horga83/Latching-Relay-Board/relay-board.pdf

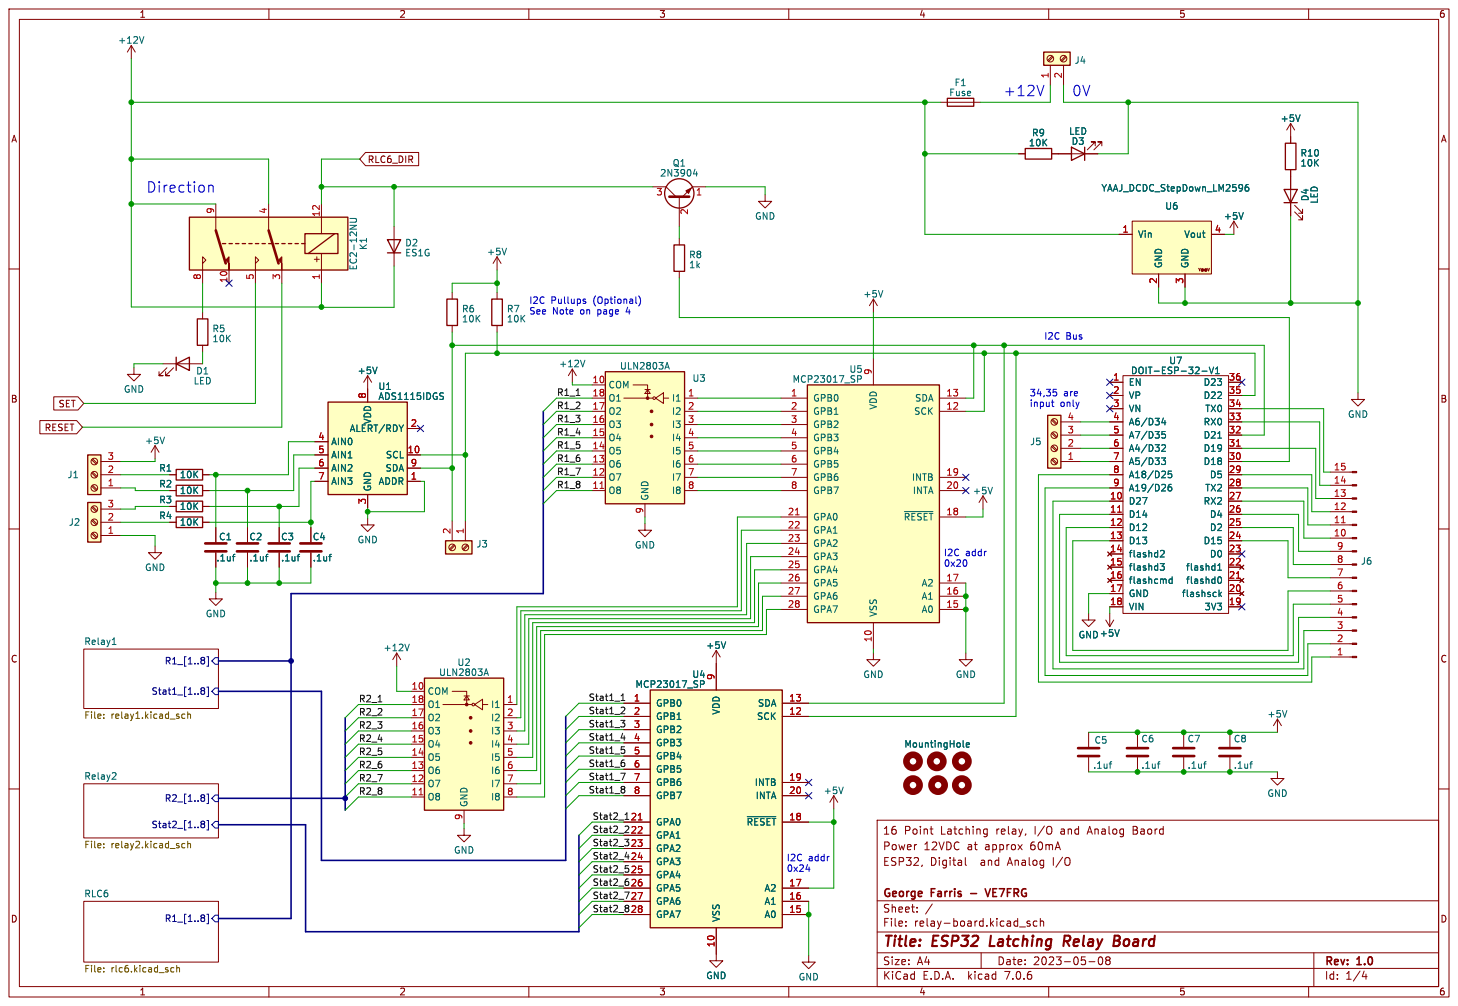
[picture p1: page 1]

3 AIN0 4 AIN1 5 AIN2 6 AIN3 7 VDD
ADDR 1 SCL 10 ALERT/RDY 2 GND

Id: 1/4 Title: ESP32 Latching Relay Board

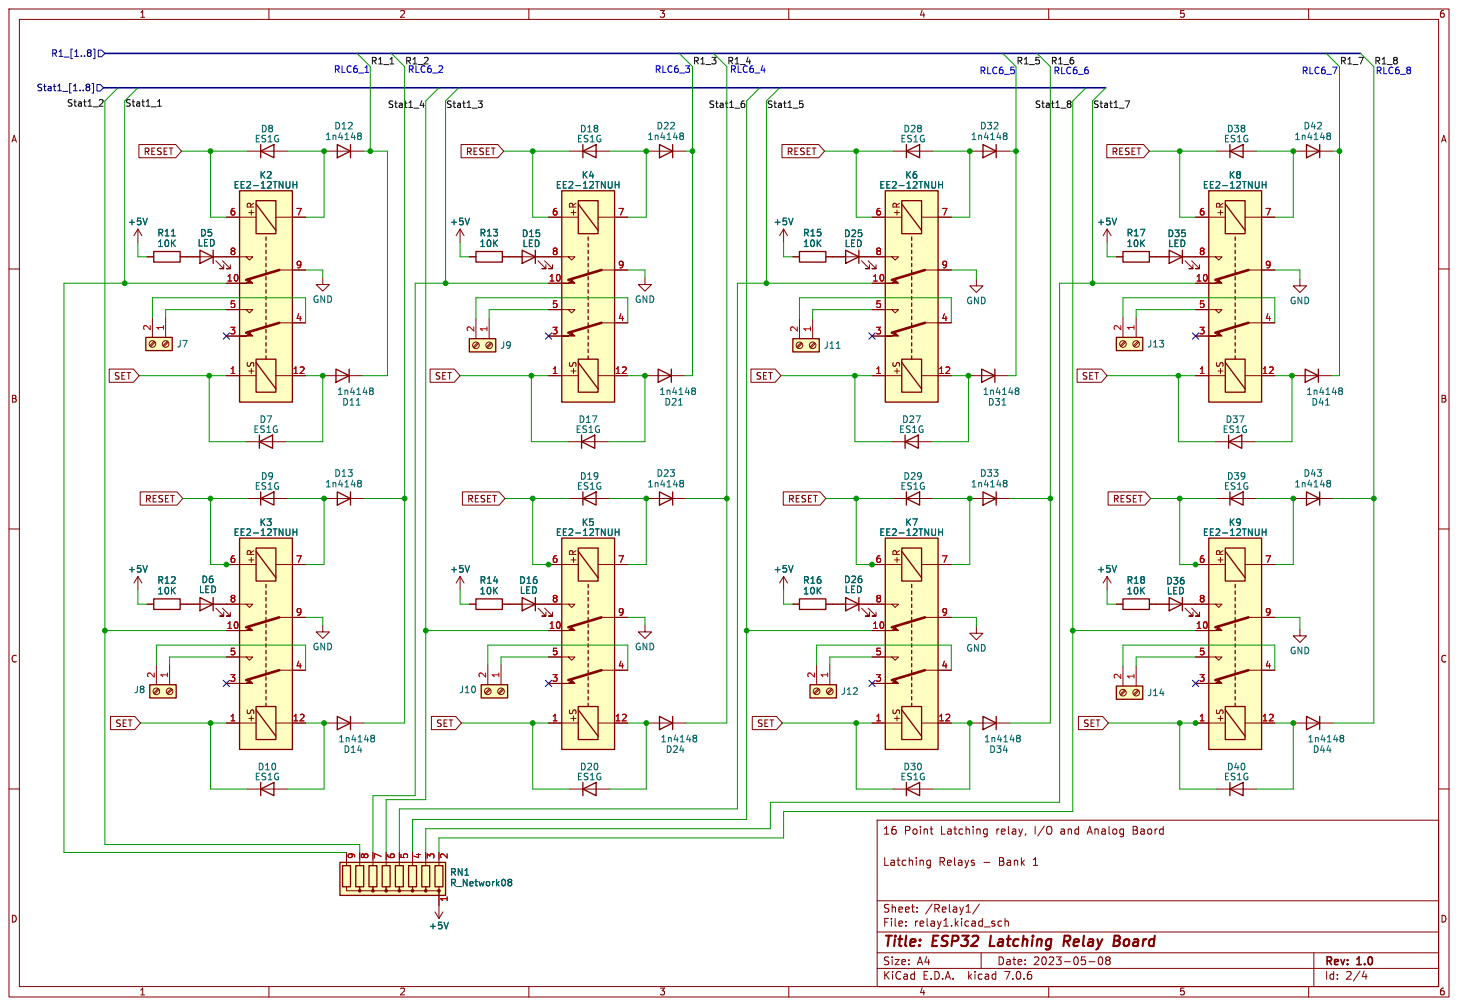
[picture p2: page 2]

File: relay1.kicad_sch Sheet: /Relay1/
Id: 2/4 Title: ESP32 Latching Relay Board

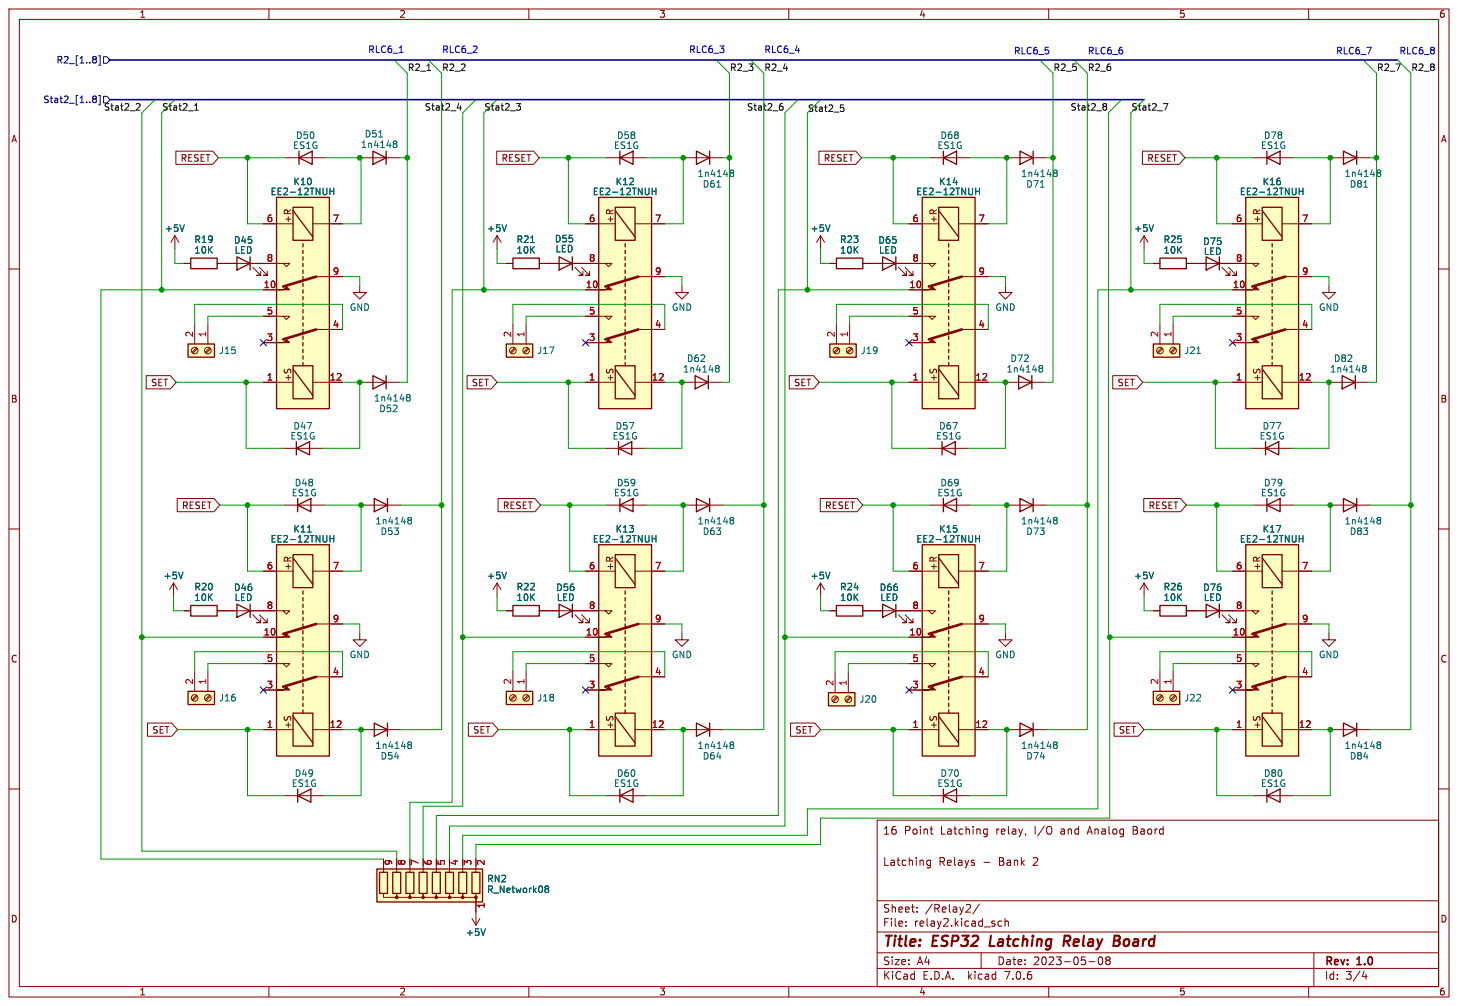
[picture p3: page 3]

File: relay2.kicad_sch Sheet: /Relay2/
Id: 3/4 Title: ESP32 Latching Relay Board

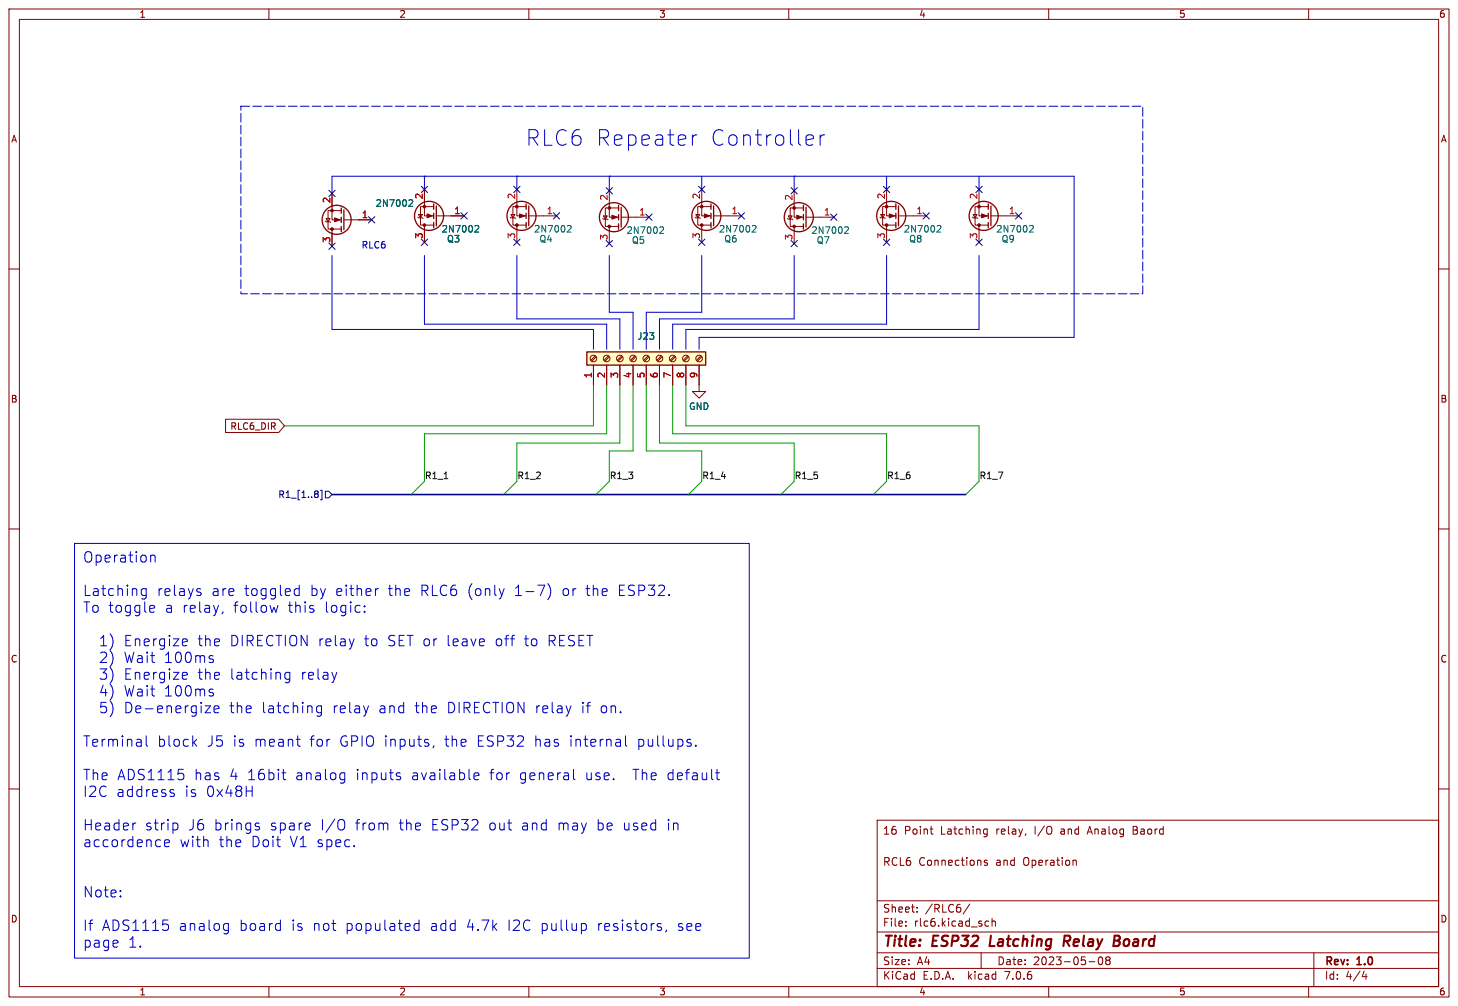
[picture p4: page 4]

Header strip J6 brings spare I/O from the ESP32 out and may be used in

Id: 4/4 Title: ESP32 Latching Relay Board
